Max-Mobility/sd-test-stand/README.md

# sd-test-stand
Test stand display, control, measurement, and validation code.
