Max-Mobility/sd-test-stand/design/SmartDriveTestStand_SingleCape_v3/TestStand_SingleCape_v3_BOM.xlsx

Part | Value | Description | Quantity on Board | Package |  |  | MANUFACTURER_PART_NUMBER | MOUSER_PART_NUMBER
C_B | 10nF 50V | TDK 2012 CGA 10nF Ceramic Multilayer Capacitor, 50 V dc, +125C, C0G Dielectric, 5% | 1 | CAPC2012X75N | https://www.mouser.com/ProductDetail/810-CGA4C2C0G1H103J | https://www.mouser.com/ProductDetail/TDK/C2012C0G1H103J060AA?qs=sGAEpiMZZMs0AnBnWHyRQFzBYxg9rzNcb4mE7BIq6H8%3d | CGA4C2C0G1H103J060AA | 810-CGA4C2C0G1H103J
C_IN, C_OUT | 180 microF 20V | Panasonic 180F 20 V dc Polymer Aluminium Electrolytic Capacitor E7, OS-CON Series 5000h 8 x 6.9mm | 2 | CAPAE1030X800N |  |  | 20SVPF180M | 667-20SVPF180M
C_INX | 100nF 16V | KEMET 100nF Multilayer Ceramic Capacitor MLCC 16V dc 10% X7R Dielectric 0603 (1608M), Max. Temp. +125C | 1 | CAPC1608X90N |  |  | C0603X104K4RACTU | 80-C0603X104K4R
C3 | 10uf,10V | Multilayer ceramic capacitor | 1 | CAPACITOR-1206 | https://www.mouser.com/ProductDetail/603-CC126ZRY5V6BB106 |  | CC1206ZRY5V6BB106
D1 | VS-5ECH06-M3/9AT | Rectifiers 5 Amp 600 Volts Hyperfast - Low QRR | 1 | SMC | https://www.mouser.com/ProductDetail/Vishay-Semiconductors/VS-5ECH06-M3-9AT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 |  | VS-5ECH06-M3/9AT
D2, D4 | RBR3LAM30BTR | Schottky Diode 3A/30V | 2 | SMA-DIODE
D5, D6 | LED_SMD-0603 | Standard LEDs - SMD WL-SMCW SMDMono TpVw Waterclr 0603 Blue | 2 | SMD 0603
D7 | B320-13-F | Diodes Inc B320-13-F, SMT Schottky Diode, 20V 3A, 2-Pin DO-214AB | 1 | DIOM7959X250N |  |  | B320-13-F | 621-B320-F
IC1 | LM2678SX-5.0_NOPB | SIMPLE SWITCHER 8V to 40V, 5A High Efficiency Step-Down DC/DC Switching Regulator | 1 | KTW0007B |  |  | LM2678SX-5.0/NOPB | 926-LM2678SX50NOPB
J1 | PJ-082BH | DC Power Connectors 2.5mm x 5.5mm horz | 1 |  | https://www.mouser.com/ProductDetail/CUI/PJ-082BH |  | PJ-082BH | 490-PJ-082BH
J2, J4 | MOLEX_15-91-3024_2POSITION | Molex Header, 2 position, with locking shroud | 2 | MOLEX15-91-3024_2POSITION | https://www.mouser.com/ProductDetail/538-15-91-3024 |  | 15-91-3024
J3 | MOLEX_15-91-3053_5POSITION | Molex Header, 5 position, with locking shroud | 1 | MOLEX15-91-3053_5POSITION | https://www.mouser.com/ProductDetail/538-15-91-3053 |  | 15-91-3053
J5 | FH12A-30S-0.5SH(55) | FFC & FPC Connectors 0.5MM 30 POS R/A TOP SMT GLD | 1 |  | https://www.mouser.com/ProductDetail/798-FH12A-30S0.5SH55 |  | FH12A-30S-0.5SH(55)
L1 | SRR1280-150M | Power inductor SMD shielded 15uH Bourns SRR1280 Series Shielded Wire-wound SMD Inductor with a Ferrite Core, 15 H 20% 5.2A Idc Q:26 | 1 | SRR1280-150M |  |  | SRR1280-150M | 652-SRR1280-150M
Q1, Q3 | UCC27511A-Q1 | Gate Drivers Sngl-Ch high-Spd Low-Side Gate Driver | 2 | SOT23-6 | https://www.mouser.com/ProductDetail/595-UCC27511AQDBVRQ1 |  | UCC27511AQDBVRQ1
Q2, Q4 | MOSFET_NCHANNELTI_CSD18533Q5A | MOSFET 60V N-Chnl NexFET Pwr MSFT, CSD18533Q5 | 2 | SON_5X6MM_NEXFET | https://www.mouser.com/ProductDetail/595-CSD18533Q5A |  | CSD18533Q5A
Q5 | AD8211YRJZ-RL7 | Current Sense Amplifiers IC High VTG | 1 | SOT23-6 | https://www.mouser.com/ProductDetail/595-OPA365AQDBVRQ1 |  | AD8211YRJZ-RL7 | 584-AD8211YRJZ-R7
Q6 | SN74LVC3G07 | Buffers & Line Drivers Triple Buffer/Driver With Open-Drain Output 8-SM8 -40 to 85 | 1 | SM-8 | https://www.mouser.com/ProductDetail/595-SN74LVC3G07DCT3 |  | SN74LVC3G07DCT3
R1 | 0.047ohm 1%, 3W | Current Sense Resistor GMR100HTBFQR047 | 1 | RESISTOR-2512 | https://www.mouser.com/ProductDetail/755-GMR100HTCFAR100 |  | GMR100HTBFQR047 | 755-GMR100HTBFQR047
R12, R13, R14, R15 | 220 Ohm 1/10W | Thin Film Resistors - SMD 1/10W 220 ohm 1% 50ppm | 4 | RESISTOR-0603
R4, R6, R7, R9, R10, R11 | 2.7k 5%, 1/10W | Resistor 2.7k 5% | 6 | RESISTOR-0603 | https://www.mouser.com/ProductDetail/603-AC0603JR-072K7L |  | AC0603JR-072K7L
Stackable Header | PRT-12790 | SparkFun Accessories Stackable Header 2x23 Pin Female | 2 |  | https://www.mouser.com/ProductDetail/474-PRT-12790 |  | PRT-12790
Receptacle Housing | 50-57-9405 | Headers & Wire Housings HSG 5P SINGLE ROW POSITIVE LATCH | 1
Receptacle Housing | 50-57-9402 | Headers & Wire Housings HSG 2P SINGLE ROW POSITIVE LATCH | 2
