Max-Mobility/sd-test-stand/design/test-stand-cape-v1/TestStand_BOM.xlsx

Part | Value | Description | Quantity on Board | Package | Mouser Link
2P Jumper | 929951-00 | Encoder Routing Jumper | 3 |  | https://www.mouser.com/ProductDetail/3M-Electronic-Solutions-Division/929951-00
BOARD1 | BEAGLEBONE_OUTLINE |  |  | BEAGLEBONE_SHIELD
C1 | 220uF, 50V | Aluminum Electrolytic Capacitor, EEE-FK1H221P | 1 | PANASONIC_G | https://www.mouser.com/ProductDetail/667-EEE-FK1H221P
C2, C3 | 10uf,10V | Multilayer ceramic capacitor | 2 | CAPACITOR-1206 | https://www.mouser.com/ProductDetail/603-CC126ZRY5V6BB106
Contact - Socket | 16-02-0102 | Headers & Wire Housings 22-24 TERMINAL BULK FEMALE | 11 |  | https://www.mouser.com/ProductDetail/538-16-02-0102
D1 | VS-5ECH06-M3/9AT | Rectifiers 5 Amp 600 Volts Hyperfast - Low QRR | 1 | SMC | https://www.mouser.com/ProductDetail/Vishay-Semiconductors/VS-5ECH06-M3-9AT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
D2, D4 | RBR3LAM30BTR | Schottky Diode 3A/30V | 2 | SMA-DIODE | https://www.mouser.com/ProductDetail/755-RBR3LAM30BTR
D3 | 5A/40V_DB2441700L | Diodes - General Purpose, Power, Switching Schottky Barrier Diode | 1 | SMA-DIODE_ALT | https://www.mouser.com/ProductDetail/Panasonic/DB2441700L
J1, J2, J3 | MOLEX_15-91-3024_2POSITION | Molex Header, 2 position, with locking shroud | 3 | MOLEX15-91-3024_2POSITION | https://www.mouser.com/ProductDetail/538-15-91-3024
J4 | MOLEX_15-91-3053_5POSITION | Molex Header, 5 position, with locking shroud | 1 | MOLEX15-91-3053_5POSITION | https://www.mouser.com/ProductDetail/538-15-91-3053
JP1 | 929665-01-06-EU | Headers & Wire Housings 12P PIN STRIP HEADER STRAIGHT, GOLD, 2ROW | 1 | 2X6 | https://www.mouser.com/ProductDetail/3M-Electronic-Solutions-Division/929665-01-06-EU
Q1, Q3 | UCC27511A-Q1 | Gate Drivers Sngl-Ch high-Spd Low-Side Gate Driver | 2 | SOT23-6 | https://www.mouser.com/ProductDetail/595-UCC27511AQDBVRQ1
Q2, Q4 | MOSFET_NCHANNELTI_CSD18533Q5A | MOSFET 60V N-Chnl NexFET Pwr MSFT, CSD18533Q5 | 2 | SON_5X6MM_NEXFET | https://www.mouser.com/ProductDetail/595-CSD18533Q5A
Q5 | OPA365AQDBVRQ1 | TI Op-Amp OPA365AQDBVRQ1 | 1 | SOT23-5 | https://www.mouser.com/ProductDetail/595-OPA365AQDBVRQ1
R1 | 0.100ohm 1%, 3W | Current Sense Resistor GMR100HTCFAR100 | 1 | RESISTOR-2512 | https://www.mouser.com/ProductDetail/755-GMR100HTCFAR100
R12, R13, R14 | 3.3k 1%, 1/10W | Resistor 3.3kOhm 1%, 1/10W | 3 | RESISTOR-0603 | https://www.mouser.com/ProductDetail/Yageo/AC0603FR-073K3L?qs=sGAEpiMZZMtlubZbdhIBINBo7nw4llFtjb1EiDJ1uvY%3d
R2, R3 | 1k 0.5%, 1/10W | Resistor 1k 0.5% | 2 | RESISTOR-0603 | https://www.mouser.com/ProductDetail/603-AT0603DRD071KL
R4, R5 | 12k 0.5%, 1/10W | Resistor 12kOhm 0.5%, 1/10W | 2 | RESISTOR-0603 | https://www.mouser.com/ProductDetail/Yageo/RT0603DRE0712KL?qs=sGAEpiMZZMu61qfTUdNhGxEjuuBLd0B49UlZCKAExZs%3d
R6, R7, R8 | 2.7k 5%, 1/10W | Resistor 2.7k 5% | 3 | RESISTOR-0603 | https://www.mouser.com/ProductDetail/603-AC0603JR-072K7L
R9, R10, R11 | 1.69k 1%, 1/10W | Resistor 1.69kOhm 1%, 1/10W | 3 | RESISTOR-0603 | https://www.mouser.com/ProductDetail/Yageo/AC0603FR-071K69L?qs=sGAEpiMZZMtlubZbdhIBIG07xJe44c5A4LLYzk1lz9M%3d
Receptacle Housing | 50-57-9405 | Headers & Wire Housings HSG 5P SINGLE ROW POSITIVE LATCH | 1 |  | https://www.mouser.com/ProductDetail/538-50-57-9405
Receptacle Housing | 50-57-9402 | Headers & Wire Housings HSG 2P SINGLE ROW POSITIVE LATCH | 3 |  | https://www.mouser.com/ProductDetail/538-50-57-9402
U1 | V_REG_LM1084 | LDO Voltage Regulator, 5V Fixed, LM1084ISX-5.0/NOPB | 1 | TO-263-3 | https://www.mouser.com/ProductDetail/926-LM1084ISX50NOPB
