Max-Mobility/sd-test-stand/design/test-stand-cape_Single-Cape_v2/TestStand_SingleCape_BOM.xlsx

Part | Value | Description | Quantity on Board | Package | Mouser Link | Current Stock | Ordered
BOARD1 | BEAGLEBONE_OUTLINE |  |  | BEAGLEBONE_SHIELD
C1 | 220uF, 50V | Aluminum Electrolytic Capacitor, EEE-FK1H221P | 1 | PANASONIC_G | https://www.mouser.com/ProductDetail/667-EEE-FK1H221P | 9
C2, C3 | 10uf,10V | Multilayer ceramic capacitor | 2 | CAPACITOR-1206 | https://www.mouser.com/ProductDetail/603-CC126ZRY5V6BB106 | 18
Contact - Socket | 16-02-0102 | Headers & Wire Housings 22-24 TERMINAL BULK FEMALE | 14 |  | https://www.mouser.com/ProductDetail/538-16-02-0102 | 45
D1 | VS-5ECH06-M3/9AT | Rectifiers 5 Amp 600 Volts Hyperfast - Low QRR | 1 | SMC | https://www.mouser.com/ProductDetail/Vishay-Semiconductors/VS-5ECH06-M3-9AT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 | 4
D2, D4 | RBR3LAM30BTR | Schottky Diode 3A/30V | 2 | SMA-DIODE | https://www.mouser.com/ProductDetail/755-RBR3LAM30BTR | 23
D3 | 5A/40V_DB2441700L | Diodes - General Purpose, Power, Switching Schottky Barrier Diode | 1 | SMA-DIODE_ALT | https://www.mouser.com/ProductDetail/Panasonic/DB2441700L | 9
D5, D6 | LED_SMD-0603 | Standard LEDs - SMD WL-SMCW SMDMono TpVw Waterclr 0603 Blue | 2 | SMD 0603 | https://www.mouser.com/ProductDetail/710-150060BS75000 | 30
J1 | PJ-082BH | DC Power Connectors 2.5mm x 5.5mm horz | 1 |  | https://www.mouser.com/ProductDetail/CUI/PJ-082BH | 9
J2, J4 | MOLEX_15-91-3024_2POSITION | Molex Header, 2 position, with locking shroud | 2 | MOLEX15-91-3024_2POSITION | https://www.mouser.com/ProductDetail/538-15-91-3024 | 17
J3 | MOLEX_15-91-3053_5POSITION | Molex Header, 5 position, with locking shroud | 1 | MOLEX15-91-3053_5POSITION | https://www.mouser.com/ProductDetail/538-15-91-3053 | 9
J5 | FH12A-30S-0.5SH(55) | FFC & FPC Connectors 0.5MM 30 POS R/A TOP SMT GLD |  |  | https://www.mouser.com/ProductDetail/798-FH12A-30S0.5SH55 | 20
Q1, Q3 | UCC27511A-Q1 | Gate Drivers Sngl-Ch high-Spd Low-Side Gate Driver | 2 | SOT23-6 | https://www.mouser.com/ProductDetail/595-UCC27511AQDBVRQ1 | 18
Q2, Q4 | MOSFET_NCHANNELTI_CSD18533Q5A | MOSFET 60V N-Chnl NexFET Pwr MSFT, CSD18533Q5 | 2 | SON_5X6MM_NEXFET | https://www.mouser.com/ProductDetail/595-CSD18533Q5A | 18
Q5 | OPA365AQDBVRQ1 | TI Op-Amp OPA365AQDBVRQ1 | 1 | SOT23-5 | https://www.mouser.com/ProductDetail/595-OPA365AQDBVRQ1 | 8
Q6 | SN74LVC3G07 | Buffers & Line Drivers Triple Buffer/Driver With Open-Drain Output 8-SM8 -40 to 85 | 1 | SM-8 | https://www.mouser.com/ProductDetail/595-SN74LVC3G07DCT3 | 11
R1 | 0.100ohm 1%, 3W | Current Sense Resistor GMR100HTCFAR100 | 1 | RESISTOR-2512 | https://www.mouser.com/ProductDetail/755-GMR100HTCFAR100 | 9
R12, R13, R14, R15 | 220 Ohm 1/10W | Thin Film Resistors - SMD 1/10W 220 ohm 1% 50ppm | 4 | RESISTOR-0603 | https://www.mouser.com/ProductDetail/Yageo/RT0603FRE07220RL | 100
R2, R3 | 1k 0.5%, 1/10W | Resistor 1k 0.5% | 2 | RESISTOR-0603 | https://www.mouser.com/ProductDetail/603-AT0603DRD071KL | 118
R4, R6, R7 | 2.7k 5%, 1/10W | Resistor 2.7k 5% | 3 | RESISTOR-0603 | https://www.mouser.com/ProductDetail/603-AC0603JR-072K7L | 127
R5, R8 | 12k 0.5%, 1/10W | Resistor 12kOhm 0.5%, 1/10W | 2 | RESISTOR-0603 | https://www.mouser.com/ProductDetail/Yageo/RT0603DRE0712KL?qs=sGAEpiMZZMu61qfTUdNhGxEjuuBLd0B49UlZCKAExZs%3d | 118
R9, R10, R11 | 10k 1%, 1/10W | Resistor 10kOhm 1%, 1/10W | 3 | RESISTOR-0603 | https://www.mouser.com/ProductDetail/Yageo/RC0603FR-0710KL | 100
Receptacle Housing | 50-57-9405 | Headers & Wire Housings HSG 5P SINGLE ROW POSITIVE LATCH | 1 |  | https://www.mouser.com/ProductDetail/538-50-57-9405 | 10
Receptacle Housing | 50-57-9402 | Headers & Wire Housings HSG 2P SINGLE ROW POSITIVE LATCH | 2 |  | https://www.mouser.com/ProductDetail/538-50-57-9402 | 15
U1 | V_REG_LM1084 | LDO Voltage Regulator, 5V Fixed, LM1084ISX-5.0/NOPB | 1 | TO-263-3 | https://www.mouser.com/ProductDetail/926-LM1084ISX50NOPB | 14
Stackable Header | PRT-12790 | SparkFun Accessories Stackable Header 2x23 Pin Female | 2 |  | https://www.mouser.com/ProductDetail/474-PRT-12790 | 12
