Max-Mobility/sd-test-stand/design/SmartDriveTestStand_SingleCape_v3/SmartDriveTestStand_SingleCape_v3.pdf

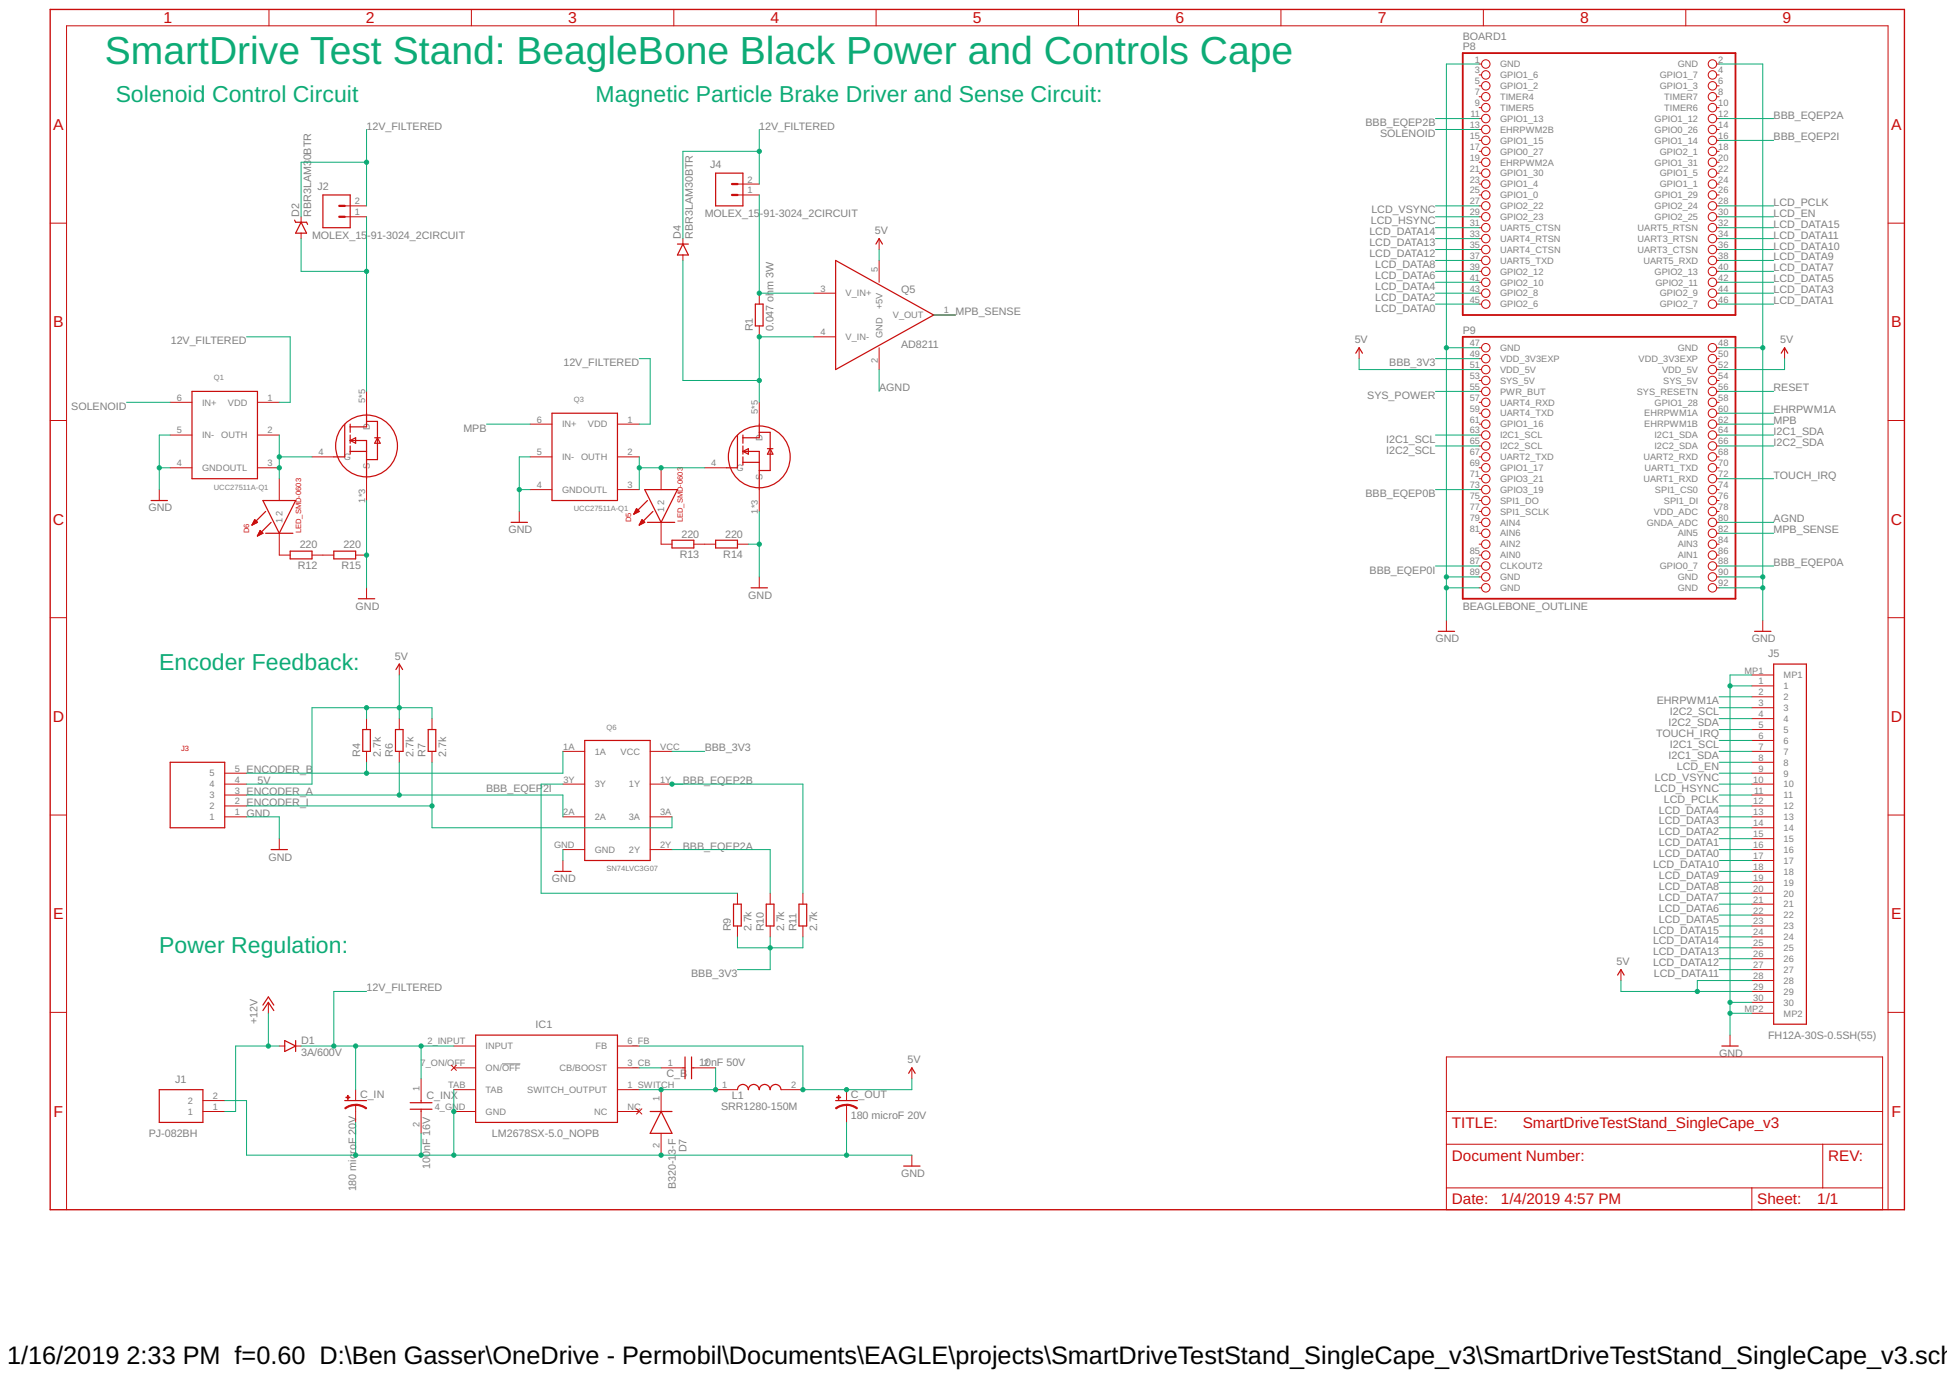
[picture p5: page 1]

LED_SMD-0603 SmartDrive Test Stand: BeagleBone Black Power and Controls Cape

Magnetic Particle Brake Driver and Sense Circuit:

1/16/2019 2:33 PM f=0.60 D:\Ben Gasser\OneDrive - Permobil\Documents\EAGLE\projects\SmartDriveTestStand_SingleCape_v3\SmartDriveTestStand_SingleCape_v3.sch (Sheet: 1/1)
