Max-Mobility/sd-test-stand/design/SmartDriveTestStand_SingleCape_v3/SmartDriveTestStand_SingleCape_v3_Board.pdf

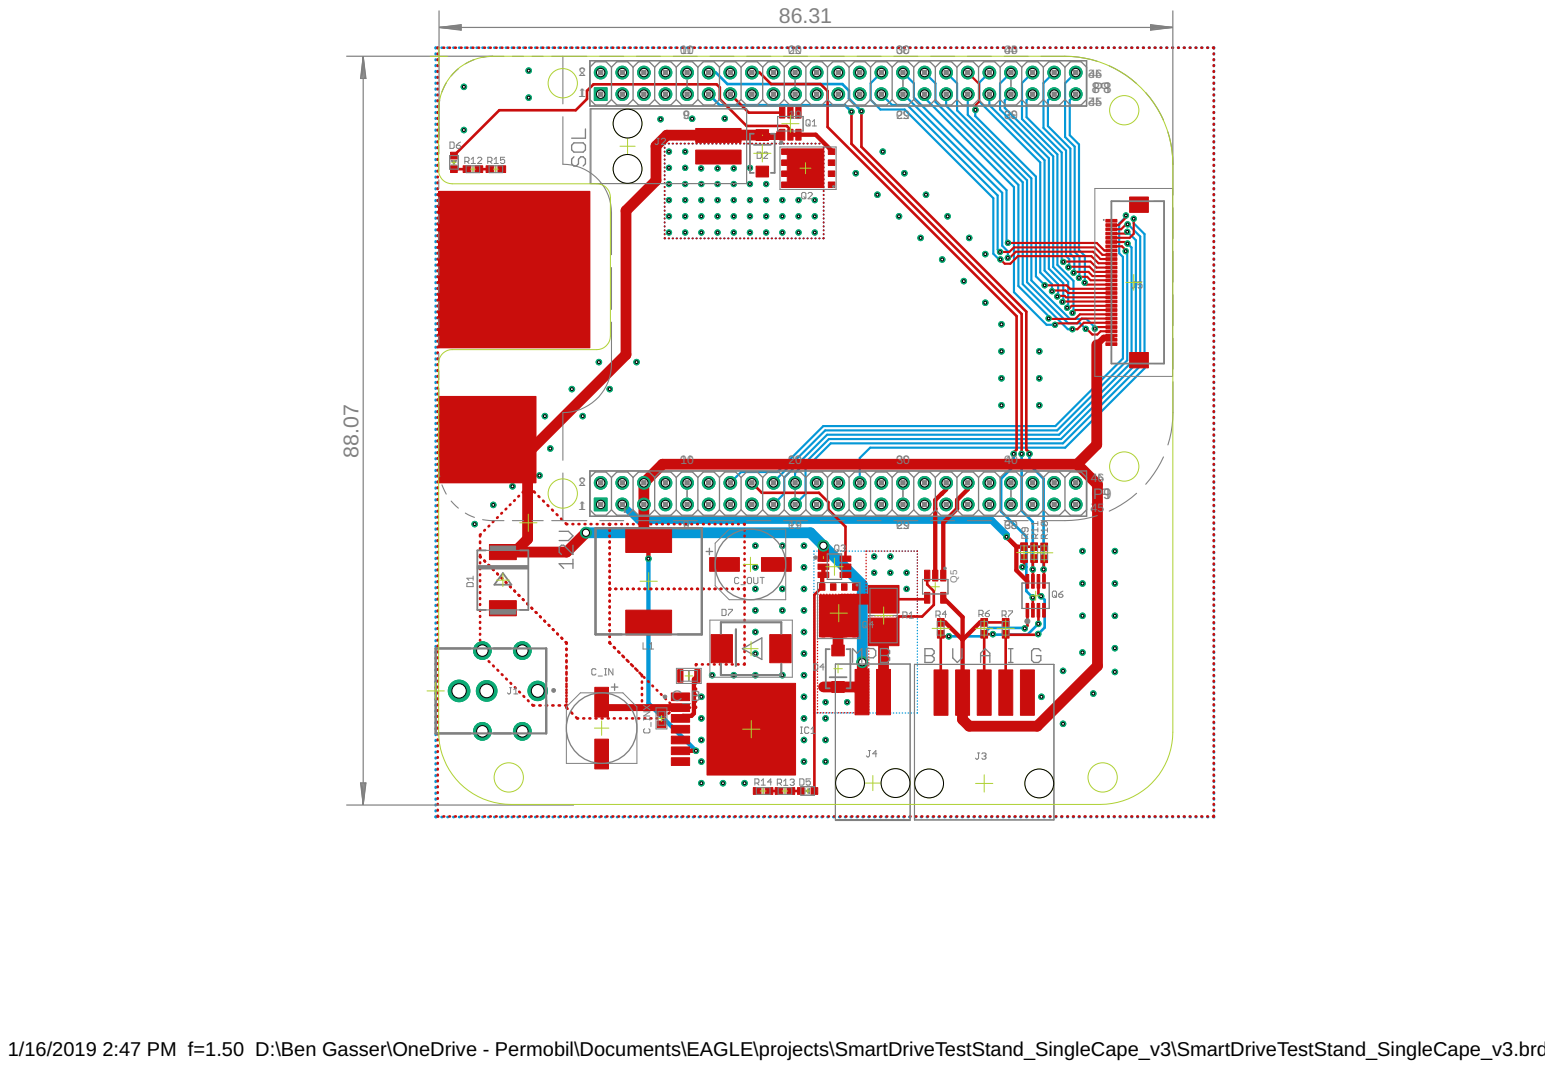
[picture p6: page 1]

1/16/2019 2:47 PM f=1.50 D:\Ben Gasser\OneDrive - Permobil\Documents\EAGLE\projects\SmartDriveTestStand_SingleCape_v3\SmartDriveTestStand_SingleCape_v3.brd
