Max-Mobility/sd-test-stand/design/SmartDriveTestStand_SingleCape_v3/SmartDriveTestStand_SingleCape_v3.brd

## EAGLE design design/SmartDriveTestStand_SingleCape_v3/SmartDriveTestStand_SingleCape_v3.brd (2019-01-17)

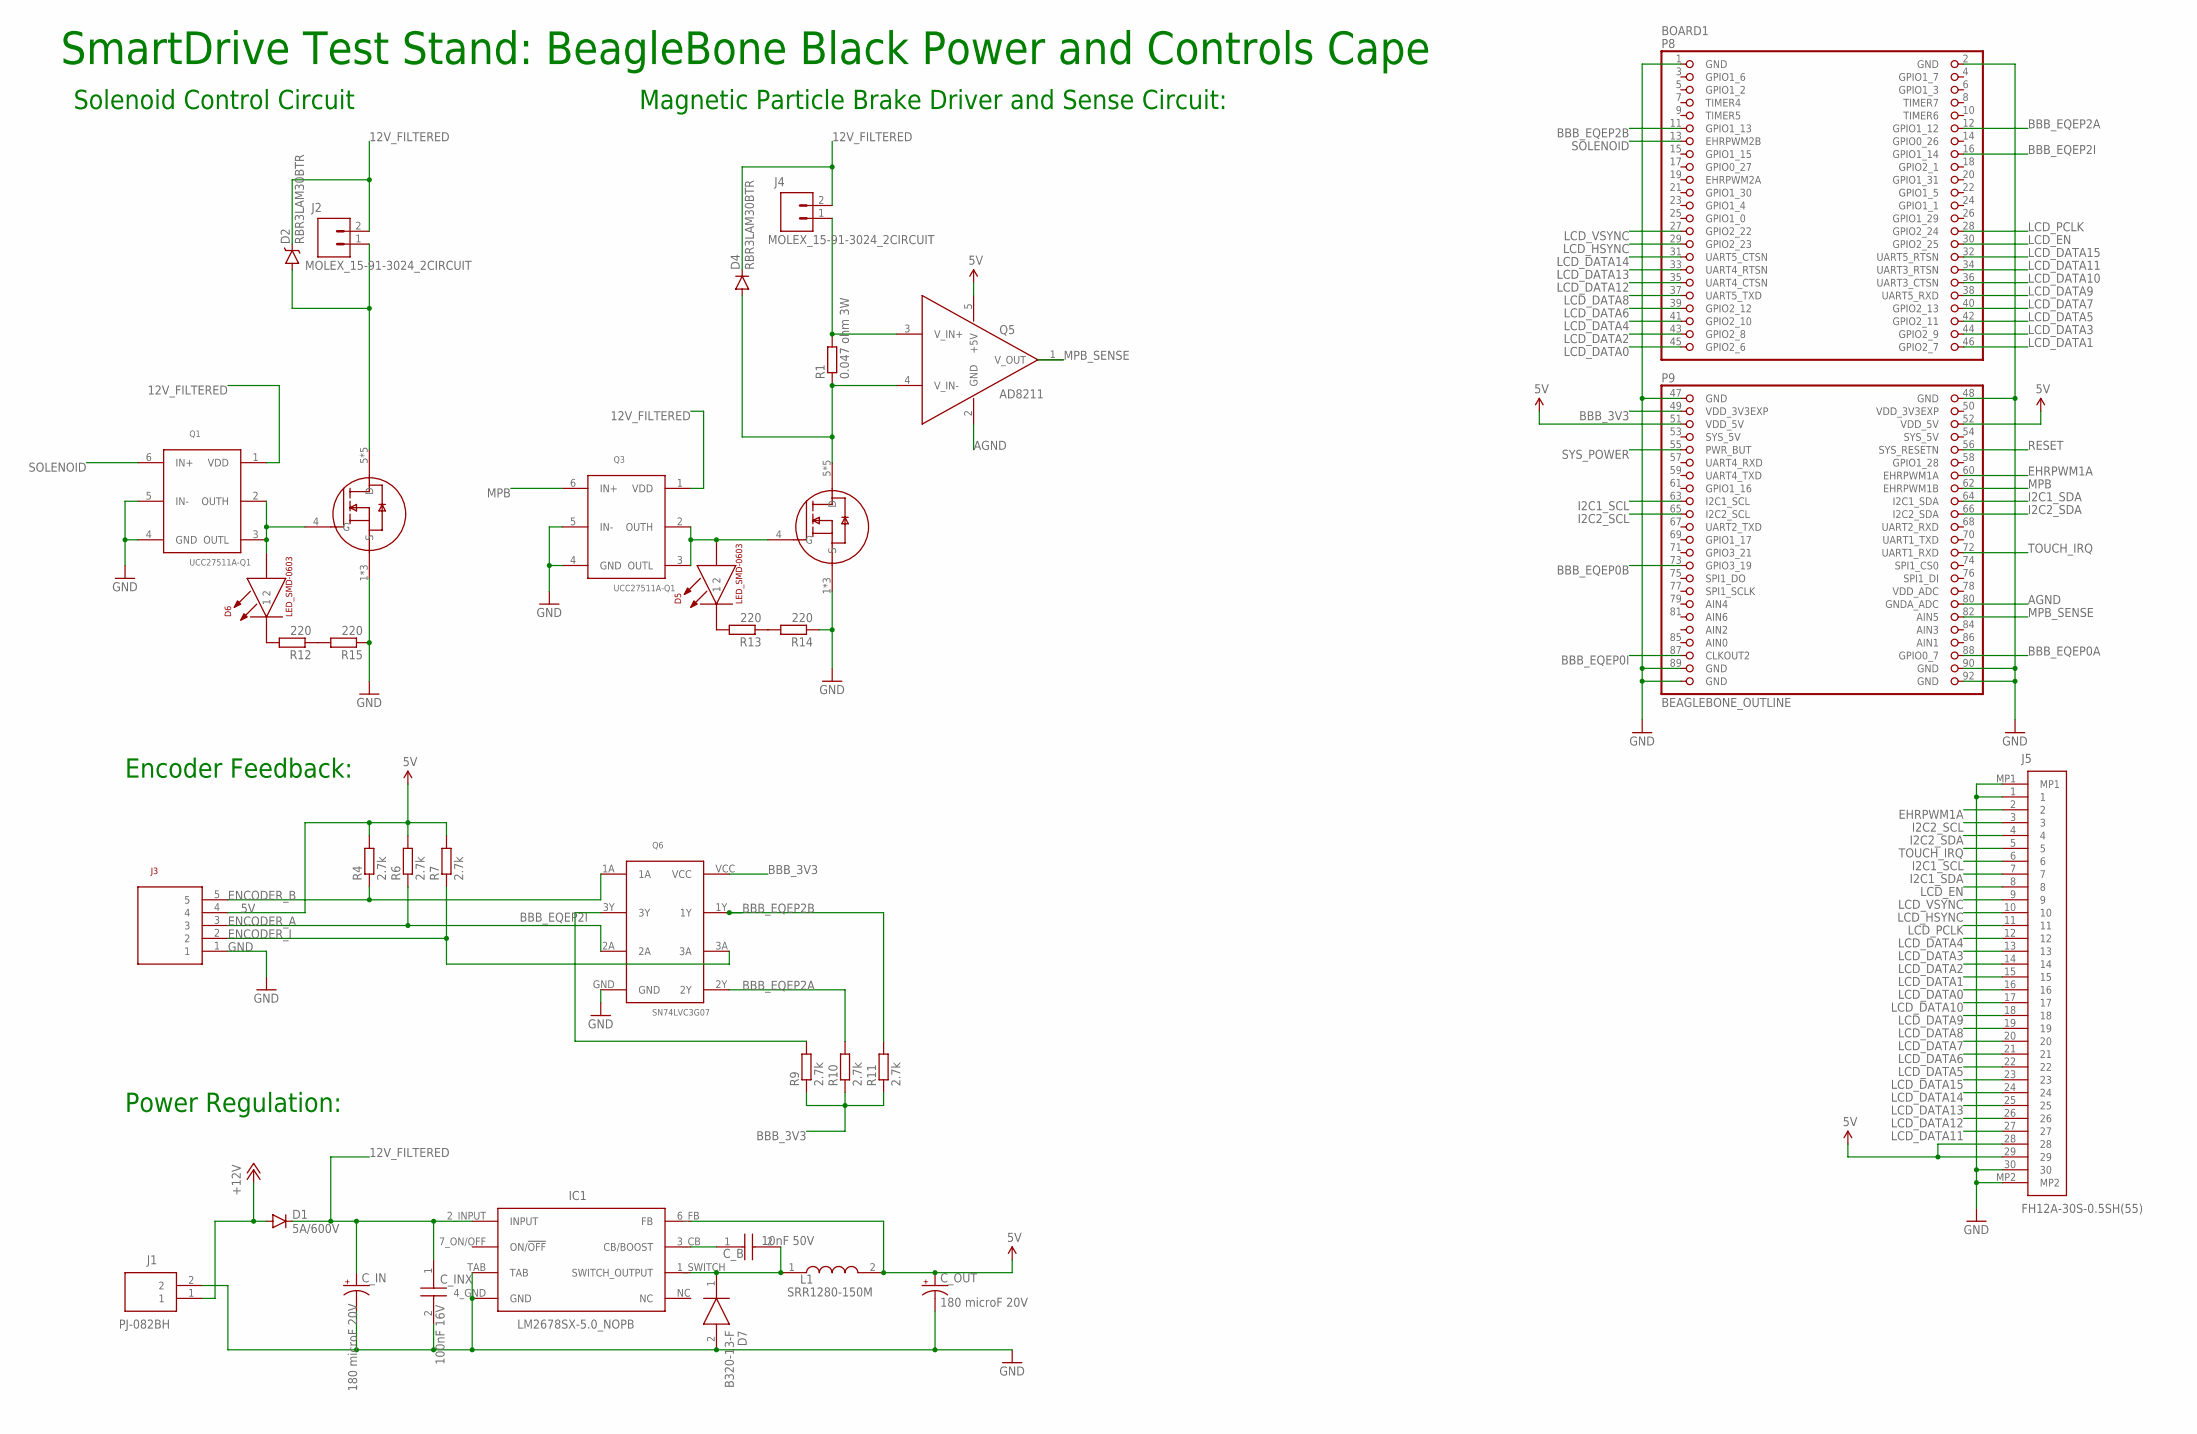
[picture p7: schematic SmartDriveTestStand_SingleCape_v3.sch]

Parts:
BOARD1: BEAGLEBONE_OUTLINE; BEAGLEBONE_SHIELD
C_B: 10nF 50V; CAPC2012X75N
C_IN: 180 microF 20V; CAPAE1030X800N
C_INX: 100nF 16V; CAPC1608X90N
C_OUT: 180 microF 20V; CAPAE1030X800N
D1: 5A/600V; SMC
D2, D4: RBR3LAM30BTR; SMA-DIODE
D5, D6: LED_SMD-0603; 0603_LED
D7: B320-13-F; DIOM7959X250N
IC1: LM2678SX-5.0_NOPB; KTW0007B
J1: PJ-082BH
J2, J4: MOLEX_15-91-3024_2CIRCUIT; MOLEX15-91-3024_2CIRCUIT
J3: MOLEX_15-91-3053_5CIRCUIT; MOLEX15-91-3053-5CIRCUIT
J5: FH12A-30S-0.5SH(55); FH12A30S05SH55
L1: SRR1280-150M
Q1, Q3: UCC27511A-Q1; SOT23-6
Q2, Q4: MOSFET_NCHANNELTI_CSD18533Q5A; SON_5X6MM_NEXFET
Q5: AD8211; SOT23-5
Q6: SN74LVC3G07
R1: 0.047 ohm 3W; RESISTOR-2512
R4, R6, R7, R9, R10, R11: 2.7k; RESISTOR-0603
R12, R13, R14, R15: 220; RESISTOR-0603

Connections:
5V: BOARD1.51 (VDD_5V), BOARD1.52 (VDD_5V), C_OUT.1 (+), IC1.6_FB (FB), J3.4, J5.28, J5.29, L1.2, Q5.5 (+5V), R4.P$2 (2), R6.P$2 (2), R7.P$2 (2)
12V_FILTERED: C_IN.1 (+), C_INX.1, D1.C, D2.C, D4.C, IC1.2_INPUT (INPUT), J2.2, J4.2, Q1.1 (VDD), Q3.1 (VDD)
+12V: D1.A, J1.1
AGND: BOARD1.80 (GNDA_ADC), Q5.2 (GND)
AIN0: BOARD1.85 (AIN0)
BBB_3V3: BOARD1.49 (VDD_3V3EXP), Q6.VCC, R9.P$1 (1), R10.P$1 (1), R11.P$1 (1)
BBB_EQEP0A: BOARD1.88 (GPIO0_7)
BBB_EQEP0B: BOARD1.73 (GPIO3_19)
BBB_EQEP0I: BOARD1.87 (CLKOUT2)
BBB_EQEP2A: BOARD1.12 (GPIO1_12), Q6.2Y, R10.P$2 (2)
BBB_EQEP2B: BOARD1.11 (GPIO1_13), Q6.1Y, R11.P$2 (2)
BBB_EQEP2I: BOARD1.16 (GPIO1_14), Q6.3Y, R9.P$2 (2)
EHRPWM1A: BOARD1.60 (EHRPWM1A), J5.2
ENCODER_A: J3.3, Q6.2A, R6.P$1 (1)
ENCODER_B: J3.5, Q6.1A, R4.P$1 (1)
ENCODER_I: J3.2, Q6.3A, R7.P$1 (1)
GND: BOARD1.1 (GND), BOARD1.2 (GND), BOARD1.47 (GND), BOARD1.48 (GND), BOARD1.89 (GND), BOARD1.90 (GND), BOARD1.91 (GND), BOARD1.92 (GND), C_IN.2 (-), C_INX.2, C_OUT.2 (-), D7.2 (A), IC1.4_GND (GND), IC1.TAB, J1.2, J3.1, J5.1, J5.30, J5.MP1, J5.MP2, Q1.4 (GND), Q1.5 (IN-), Q2.1 (S), Q2.2 (S), Q2.3 (S), Q3.4 (GND), Q3.5 (IN-), Q4.1 (S), Q4.2 (S), Q4.3 (S), Q6.GND, R14.P$1 (1), R15.P$1 (1)
I2C1_SCL: BOARD1.63 (I2C1_SCL), J5.6
I2C1_SDA: BOARD1.64 (I2C1_SDA), J5.7
I2C2_SCL: BOARD1.65 (I2C2_SCL), J5.3
I2C2_SDA: BOARD1.66 (I2C2_SDA), J5.4
LCD_DATA0: BOARD1.45 (GPIO2_6), J5.16
LCD_DATA1: BOARD1.46 (GPIO2_7), J5.15
LCD_DATA2: BOARD1.43 (GPIO2_8), J5.14
LCD_DATA3: BOARD1.44 (GPIO2_9), J5.13
LCD_DATA4: BOARD1.41 (GPIO2_10), J5.12
LCD_DATA5: BOARD1.42 (GPIO2_11), J5.22
LCD_DATA6: BOARD1.39 (GPIO2_12), J5.21
LCD_DATA7: BOARD1.40 (GPIO2_13), J5.20
LCD_DATA8: BOARD1.37 (UART5_TXD), J5.19
LCD_DATA9: BOARD1.38 (UART5_RXD), J5.18
LCD_DATA10: BOARD1.36 (UART3_CTSN), J5.17
LCD_DATA11: BOARD1.34 (UART3_RTSN), J5.27
LCD_DATA12: BOARD1.35 (UART4_CTSN), J5.26
LCD_DATA13: BOARD1.33 (UART4_RTSN), J5.25
LCD_DATA14: BOARD1.31 (UART5_CTSN), J5.24
LCD_DATA15: BOARD1.32 (UART5_RTSN), J5.23
LCD_EN: BOARD1.30 (GPIO2_25), J5.8
LCD_HSYNC: BOARD1.29 (GPIO2_23), J5.10
LCD_PCLK: BOARD1.28 (GPIO2_24), J5.11
LCD_VSYNC: BOARD1.27 (GPIO2_22), J5.9
MPB: BOARD1.62 (EHRPWM1B), Q3.6 (IN+)
MPB_SENSE: BOARD1.82 (AIN5), Q5.1 (V_OUT)
unnamed: R13.P$1 (1), R14.P$2 (2)
unnamed: D4.A, Q4.5 (D), Q4.6 (D), Q4.7 (D), Q4.8 (D), Q4.PAD (D), Q5.4 (V_IN-), R1.1
unnamed: D5.C (1), R13.P$2 (2)
unnamed: D6.C (1), R12.P$2 (2)
unnamed: D2.A, J2.1, Q2.5 (D), Q2.6 (D), Q2.7 (D), Q2.8 (D), Q2.PAD (D)
unnamed: J4.1, Q5.3 (V_IN+), R1.2
unnamed: R12.P$1 (1), R15.P$2 (2)
unnamed: D5.A (2), Q3.2 (OUTH), Q3.3 (OUTL), Q4.4 (G)
unnamed: D6.A (2), Q1.2 (OUTH), Q1.3 (OUTL), Q2.4 (G)
unnamed: C_B.2, D7.1 (K), IC1.1_SWITCH (SWITCH_OUTPUT), L1.1
unnamed: C_B.1, IC1.3_CB (CB/BOOST)
RESET: BOARD1.56 (SYS_RESETN)
SOLENOID: BOARD1.13 (EHRPWM2B), Q1.6 (IN+)
SYS_5V: BOARD1.53 (SYS_5V)
SYS_POWER: BOARD1.55 (PWR_BUT)
TOUCH_IRQ: BOARD1.72 (UART1_RXD), J5.5
VDD_3V3EXP: BOARD1.50 (VDD_3V3EXP)

Notes on the sheet:
SmartDrive Test Stand: BeagleBone Black Power and Controls Cape
Power Regulation:
Magnetic Particle Brake Driver and Sense Circuit:
Encoder Feedback:
Solenoid Control Circuit

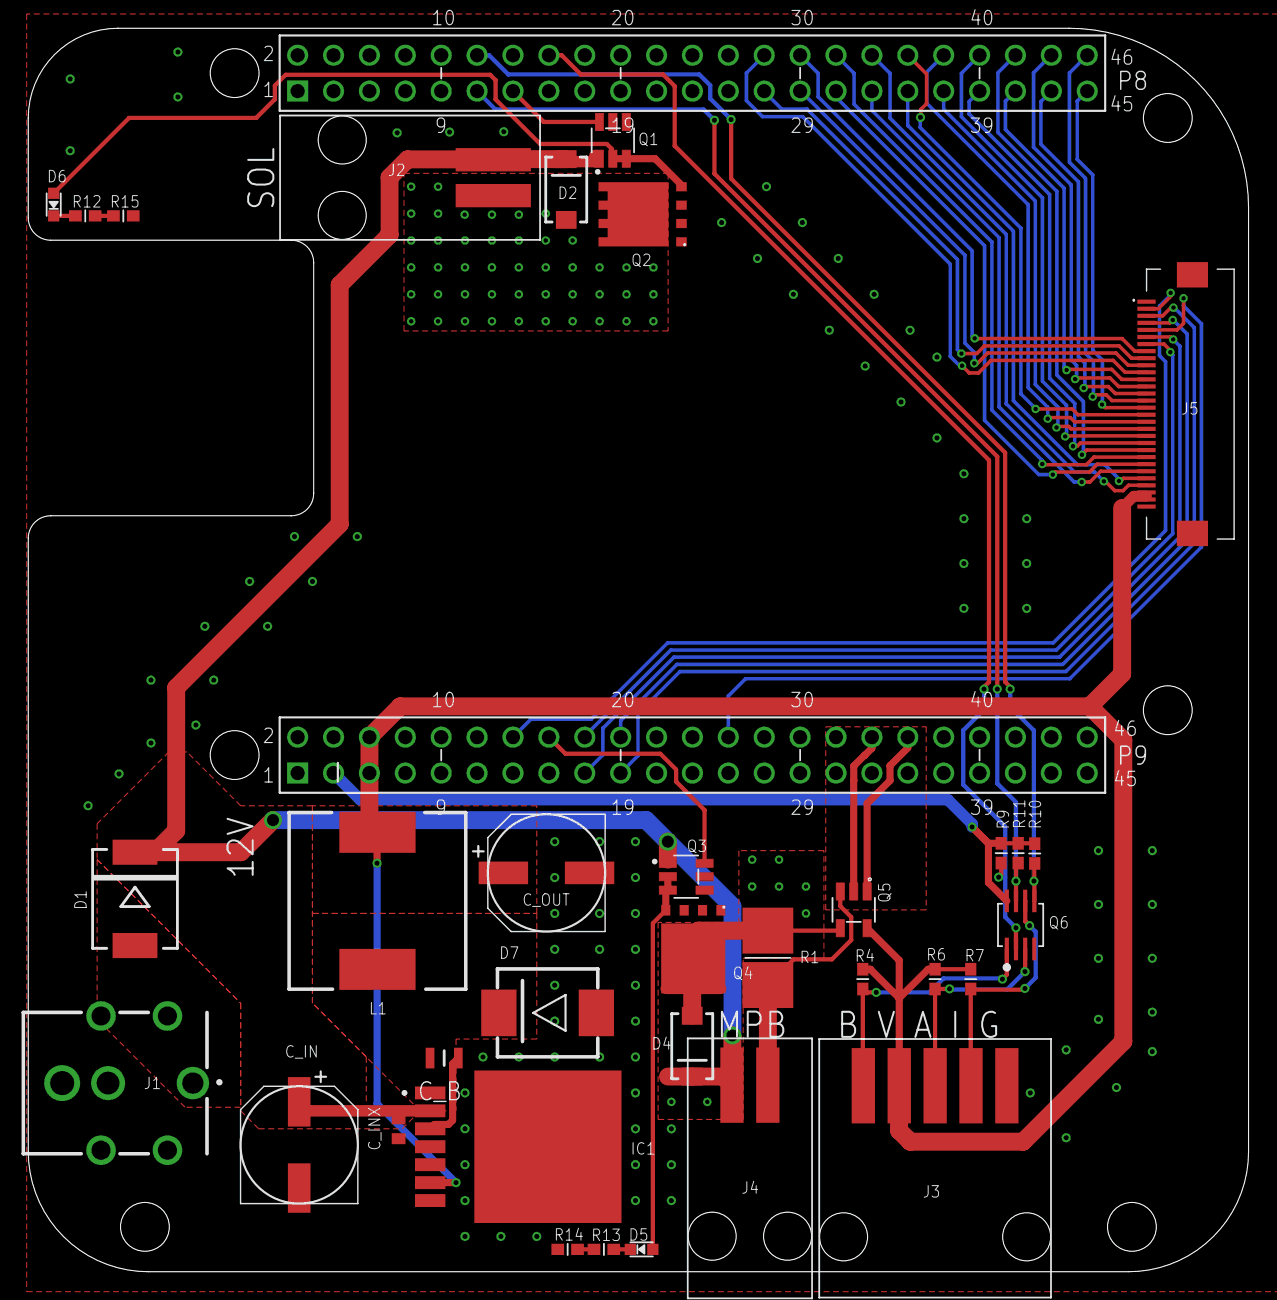
[picture p8: board SmartDriveTestStand_SingleCape_v3.brd from above]

Board: 2 copper layers, 86.4 x 88.0 mm, 36 parts (0 on the bottom side), 52 nets.

Other parts of the board:
DRILEGEND: DRILEGEND
