Max-Mobility/sd-test-stand/design/test-stand-cape-v1/SmartDriveTestStand.brd

## EAGLE design design/test-stand-cape-v1/SmartDriveTestStand.brd (2018-11-27)

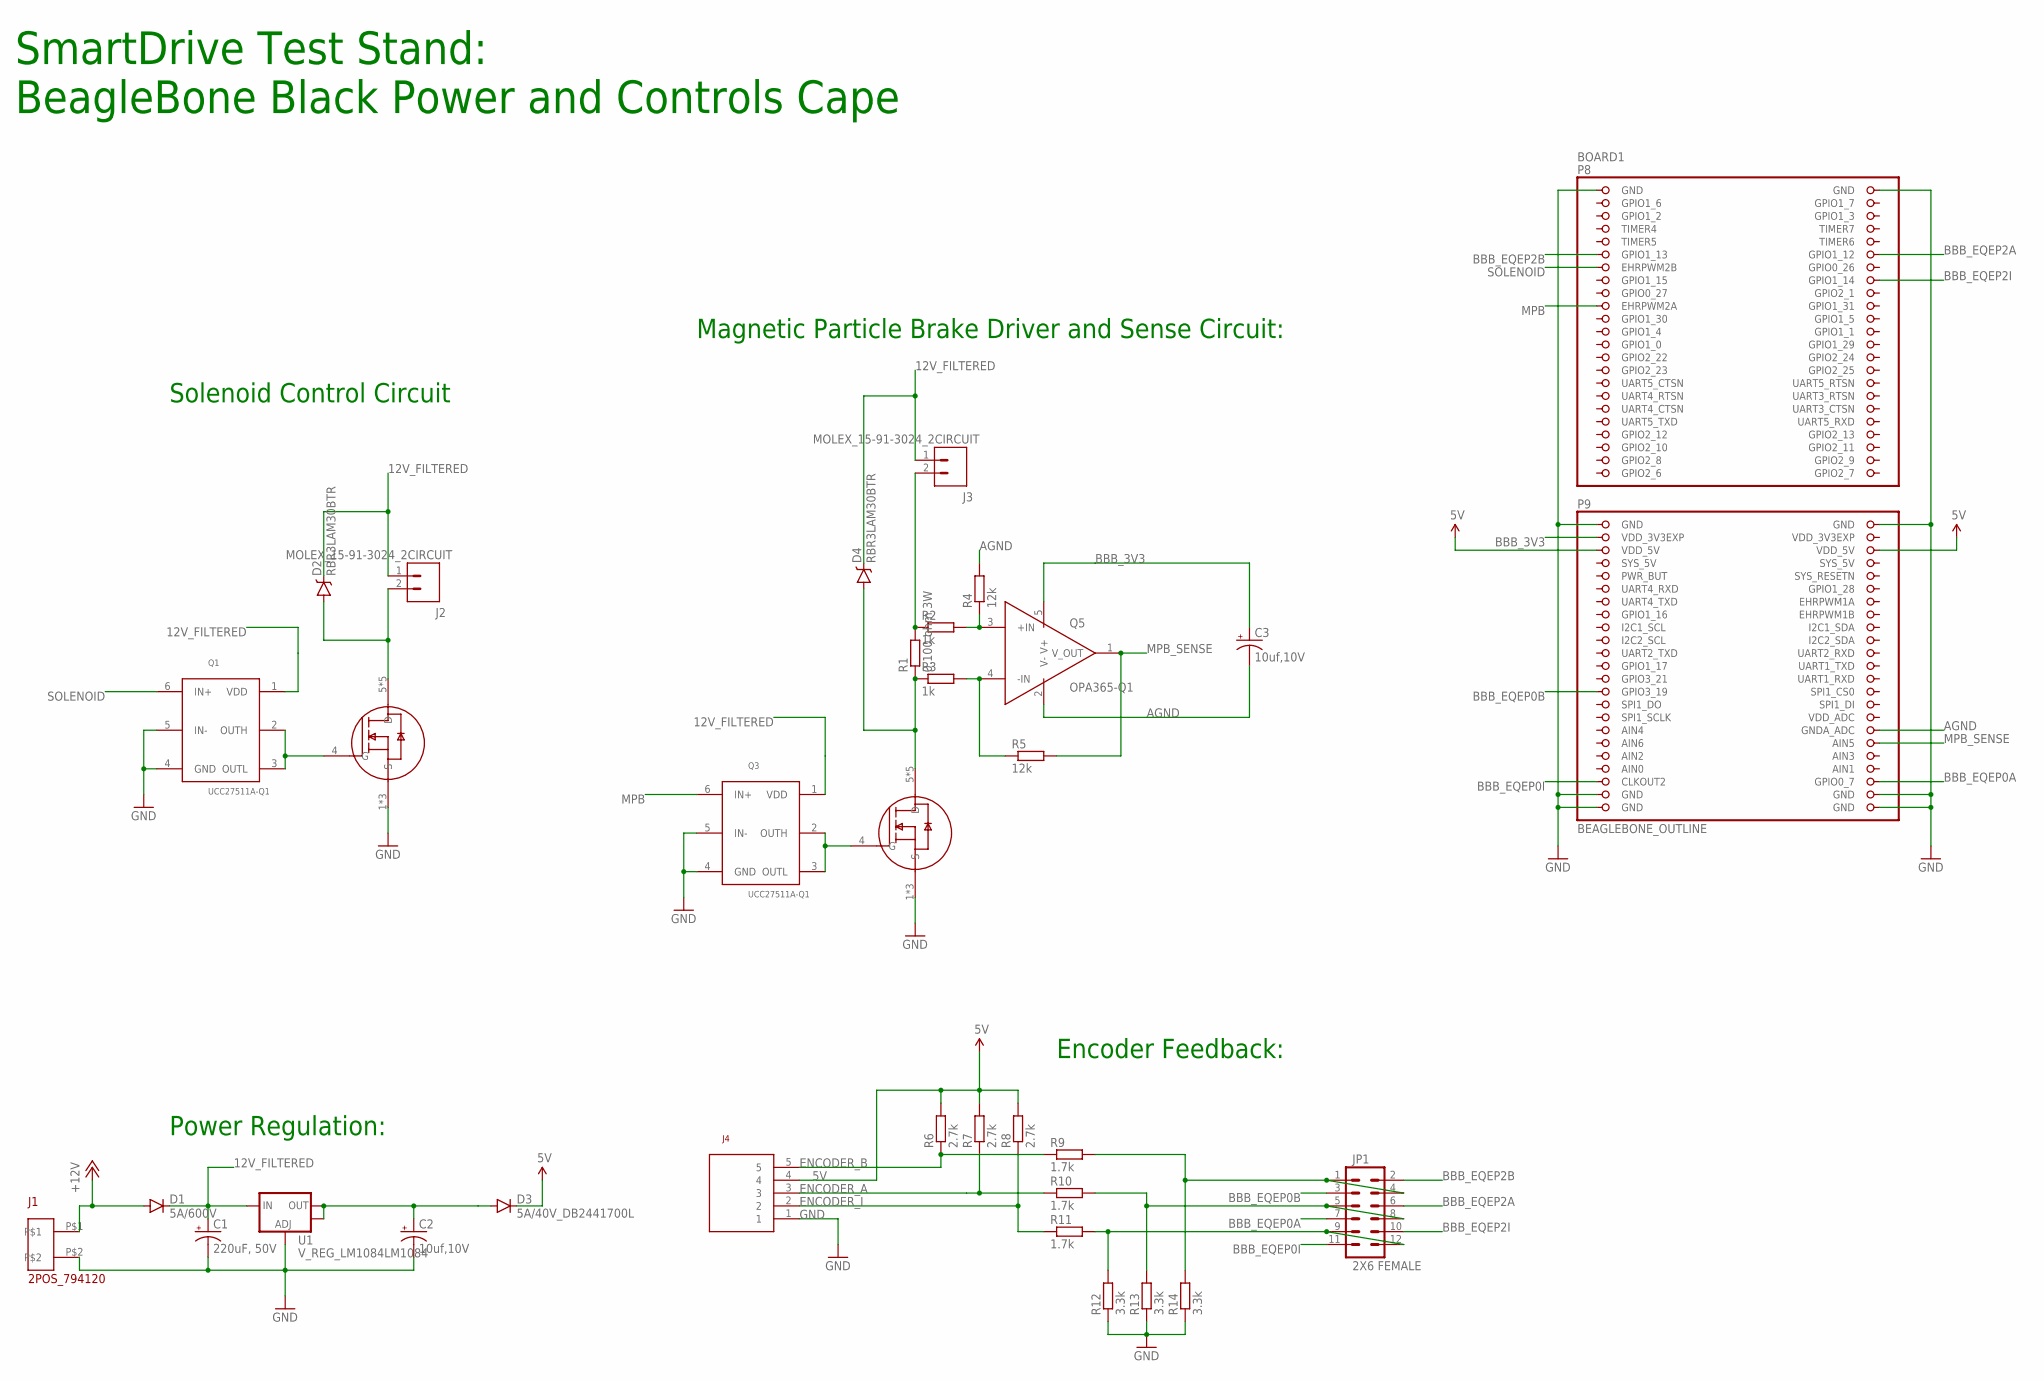
[picture p9: schematic SmartDriveTestStand.sch]

Parts:
BOARD1: BEAGLEBONE_OUTLINE; BEAGLEBONE_SHIELD
C1: 220uF, 50V; PANASONIC_G
C2, C3: 10uf,10V; EIA3216
D1: 5A/600V; SMC
D2, D4: RBR3LAM30BTR; SMA-DIODE
D3: 5A/40V_DB2441700L; SMA-DIODE_ALT
J1: 2POS_794120; 2POS_794120-1
J2, J3: MOLEX_15-91-3024_2CIRCUIT; MOLEX15-91-3024_2CIRCUIT
J4: MOLEX_15-91-3053_5CIRCUIT; MOLEX15-91-3053-5CIRCUIT
JP1: 2X6 FEMALE; 2X6
Q1, Q3: UCC27511A-Q1; SOT23-6
Q2, Q4: MOSFET_NCHANNELTI_CSD18533Q5A; SON_5X6MM_NEXFET
Q5: OPA365-Q1; SOT23-5
R1: 0.100 ohm 3W; RESISTOR-2512
R2, R3: 1k; RESISTOR-0603
R4, R5: 12k; RESISTOR-0603
R6, R7, R8: 2.7k; RESISTOR-0603
R9, R10, R11: 1.7k; RESISTOR-0603
R12, R13, R14: 3.3k; RESISTOR-0603
U1: V_REG_LM1084LM1084; TO-263-3

Connections:
5V: BOARD1.51 (VDD_5V), BOARD1.52 (VDD_5V), D3.C, J4.4, R6.P$2 (2), R7.P$2 (2), R8.P$2 (2)
12V_FILTERED: C1.+, D1.C, D2.C, D4.C, J2.1, J3.1, Q1.1 (VDD), Q3.1 (VDD), U1.3 (IN)
+12V: D1.A, J1.P$1
AGND: BOARD1.80 (GNDA_ADC), C3.C (-), Q5.2 (V-), R4.P$2 (2)
AIN0: BOARD1.85 (AIN0)
BBB_3V3: BOARD1.49 (VDD_3V3EXP), C3.A (+), Q5.5 (V+)
BBB_EQEP0A: BOARD1.88 (GPIO0_7), JP1.7
BBB_EQEP0B: BOARD1.73 (GPIO3_19), JP1.3
BBB_EQEP0I: BOARD1.87 (CLKOUT2), JP1.11
BBB_EQEP2A: BOARD1.12 (GPIO1_12), JP1.6
BBB_EQEP2B: BOARD1.11 (GPIO1_13), JP1.2
BBB_EQEP2I: BOARD1.16 (GPIO1_14), JP1.10
ENCA_1V8: JP1.5, JP1.8, R10.P$2 (2), R13.P$2 (2)
ENCB_1V8: JP1.1, JP1.4, R9.P$2 (2), R14.P$2 (2)
ENCI_1V8: JP1.9, JP1.12, R11.P$2 (2), R12.P$2 (2)
ENCODER_A: J4.3, R7.P$1 (1), R10.P$1 (1)
ENCODER_B: J4.5, R6.P$1 (1), R9.P$1 (1)
ENCODER_I: J4.2, R8.P$1 (1), R11.P$1 (1)
GND: BOARD1.1 (GND), BOARD1.2 (GND), BOARD1.47 (GND), BOARD1.48 (GND), BOARD1.89 (GND), BOARD1.90 (GND), BOARD1.91 (GND), BOARD1.92 (GND), C1.-, C2.C (-), J1.P$2, J4.1, Q1.4 (GND), Q1.5 (IN-), Q2.1 (S), Q2.2 (S), Q2.3 (S), Q3.4 (GND), Q3.5 (IN-), Q4.1 (S), Q4.2 (S), Q4.3 (S), R12.P$1 (1), R13.P$1 (1), R14.P$1 (1), U1.1 (ADJ)
MPB: BOARD1.19 (EHRPWM2A), Q3.6 (IN+)
MPB_SENSE: BOARD1.82 (AIN5), Q5.1 (V_OUT), R5.P$2 (2)
unnamed: Q3.2 (OUTH), Q3.3 (OUTL), Q4.4 (G)
unnamed: D4.A, Q4.5 (D), Q4.6 (D), Q4.7 (D), Q4.8 (D), Q4.PAD (D), R1.1, R3.P$1 (1)
unnamed: Q5.3 (+IN), R2.P$2 (2), R4.P$1 (1)
unnamed: Q5.4 (-IN), R3.P$2 (2), R5.P$1 (1)
unnamed: Q1.2 (OUTH), Q1.3 (OUTL), Q2.4 (G)
unnamed: D2.A, J2.2, Q2.5 (D), Q2.6 (D), Q2.7 (D), Q2.8 (D), Q2.PAD (D)
unnamed: J3.2, R1.2, R2.P$1 (1)
SOLENOID: BOARD1.13 (EHRPWM2B), Q1.6 (IN+)
SYS_5V: BOARD1.53 (SYS_5V)
VDD_3V3EXP: BOARD1.50 (VDD_3V3EXP)
VOUT: C2.A (+), D3.A, U1.2 (OUT), U1.4 (OUT)

Notes on the sheet:
SmartDrive Test Stand: BeagleBone Black Power and Controls Cape
Power Regulation:
Magnetic Particle Brake Driver and Sense Circuit:
Encoder Feedback:
Solenoid Control Circuit

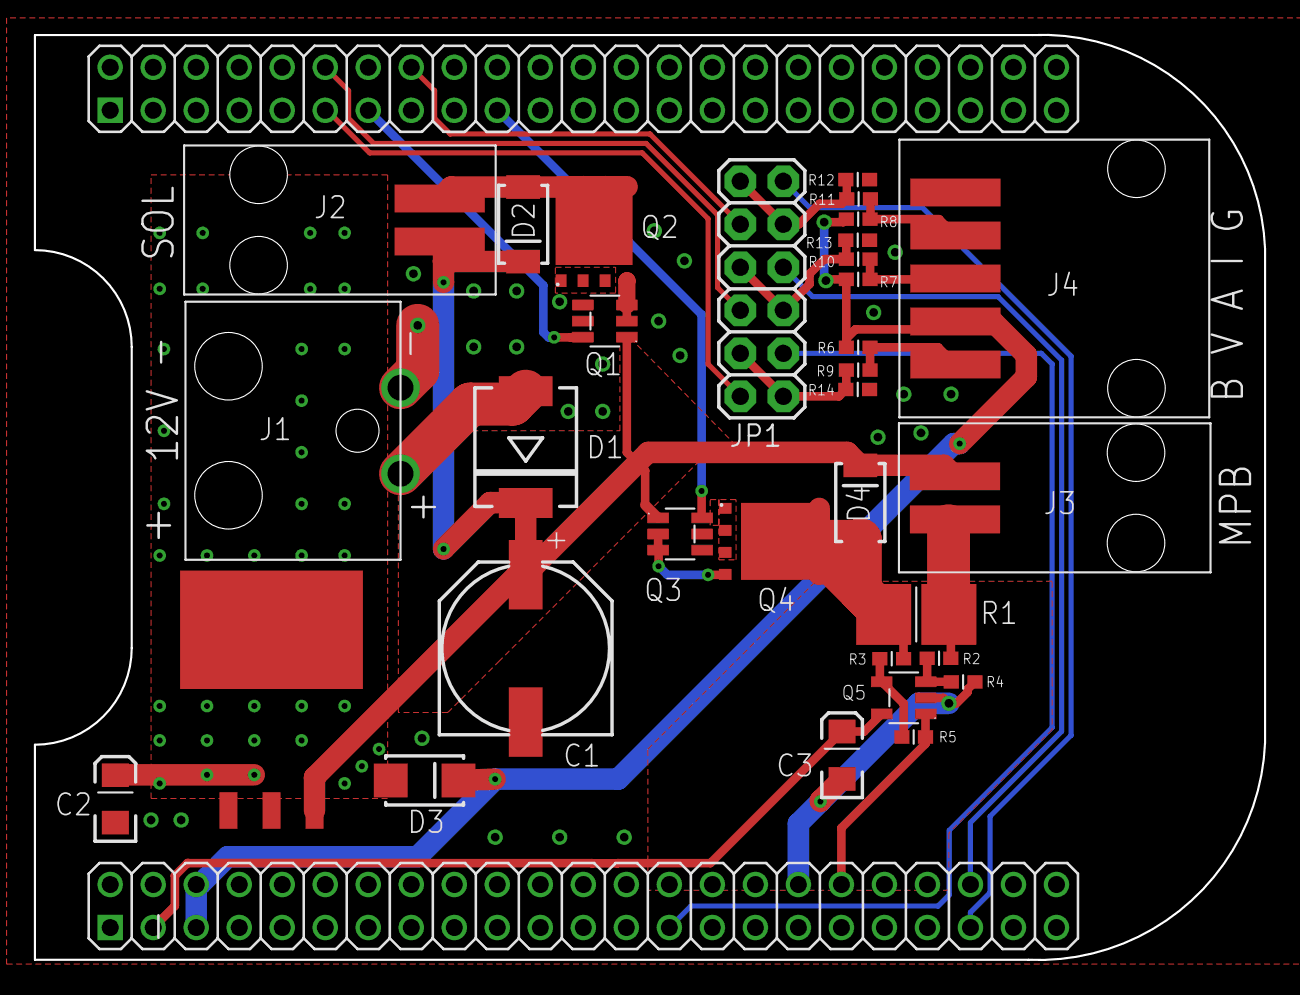
[picture p10: board SmartDriveTestStand.brd from above]

Board: 2 copper layers, 72.6 x 54.6 mm, 34 parts (0 on the bottom side), 29 nets.

Other parts of the board:
DRILEGEND: DRILEGEND
