Max-Mobility/sd-test-stand/(commit log)

2019-01-16 WIP adding reading of encoder and control over PWM to ui code.
2019-01-16 cleanup PWM resources / shut off channels when closing.
2019-01-16 continuing to flesh out pin controls.
2019-01-17 working on fleshing out the ui for working event binding and data display.
    [pages.py, ui.py]
2019-01-17 added zero load button and updated progress bar display.
2019-01-21 WIP adding encoder speed measurement / computation / display
